VojtaT04/pulzni-oxymetrie/Finální_verze.stl

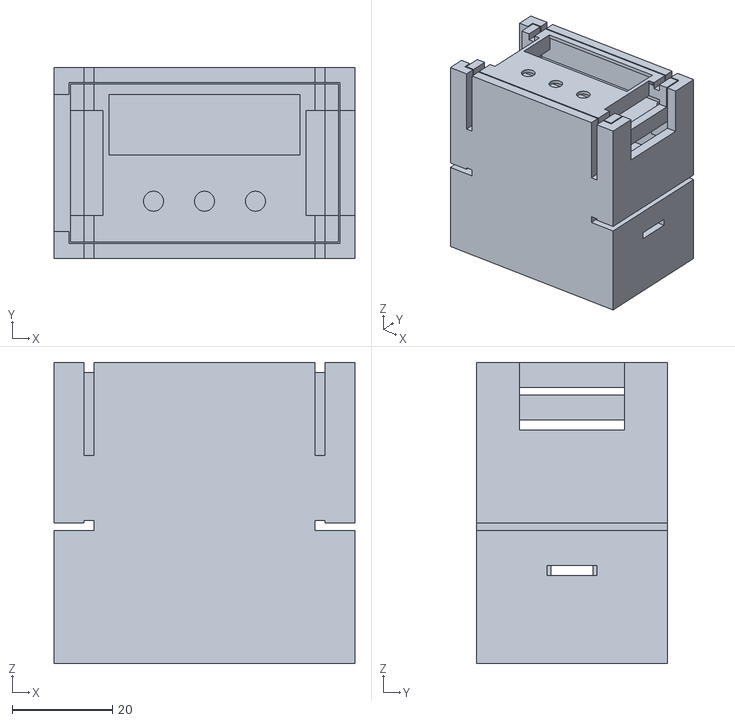
[picture p1: CAD file, 2023-01-30]
Finální_verze.stl
60.0 x 38.0 x 60.0
